Jarom-W/bikespeed/bikespeed.kicad_sch

## KiCad design bikespeed.kicad_sch (2026-11-02)

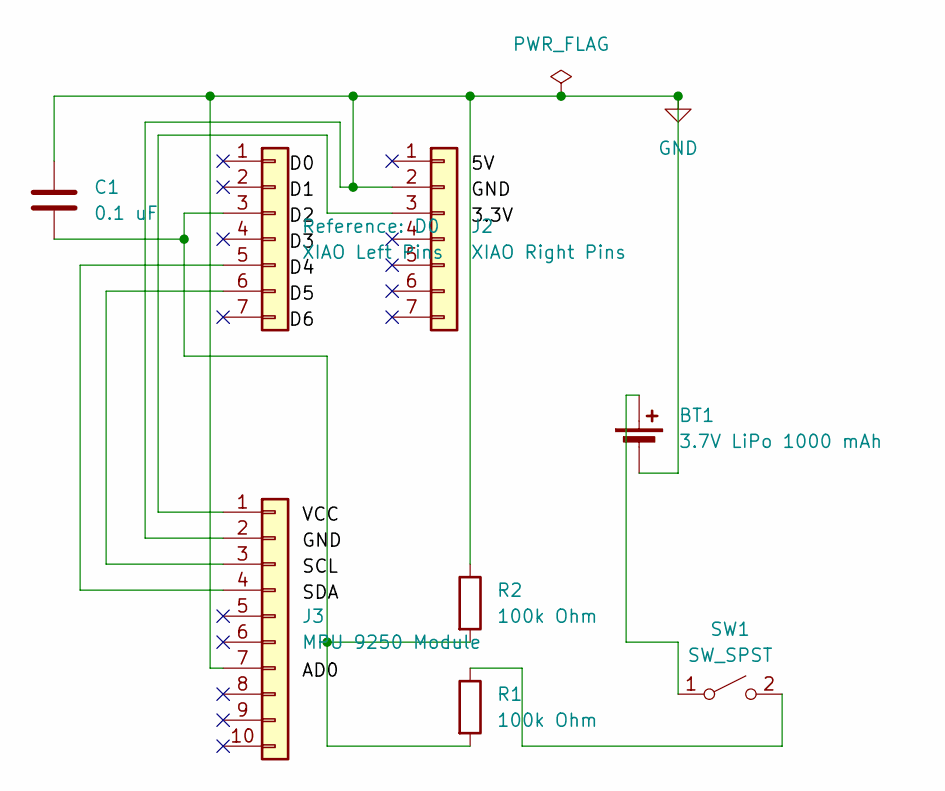
[picture p1: schematic bikespeed.kicad_sch]

Parts:
BT1: 3.7V LiPo 1000 mAh
C1: 0.1 uF
D0: XIAO Left Pins
J2: XIAO Right Pins
J3: MPU 9250 Module
R1, R2: 100k Ohm
SW1: SW_SPST

Connections:
GND: BT1.2 (-), C1.1, J2.2, J3.2, J3.7, R2.1
unnamed: BT1.1 (+), SW1.1 (A)
unnamed: C1.2, D0.3, R1.2, R2.2
unnamed: D0.5, J3.4
unnamed: D0.6, J3.3
unnamed: J2.3, J3.1
unnamed: R1.1, SW1.2 (B)
